federico-germinario/Pleasent_Ride/README.md

# Pleasent Ride

# Descrizione del progetto

L’obiettivo che ci siamo posti per questo progetto è stato quello di creare un dispositivo che raccolga dei dati riguardanti la qualità dell’aria e del manto stradale in alcuni tratti di strada di una città e che invii questi dati ad un cloud, che mostra in ogni momento il loro andamento.
L’idea è quindi quella di creare un sistema che, raccogliendo le informazioni sopracitate in tempo reale, possa fornire agli utenti la possibilità di scegliere il tragitto più piacevole possibile per spostarsi fra le strade di una città.   
Il dispositivo è pensato principalmente per le biciclette ma può essere adattato a qualsiasi mezzo che possa risentire di inquinamento e strade imperfette.
