federico-germinario/Pleasent_Ride/Slide.pdf

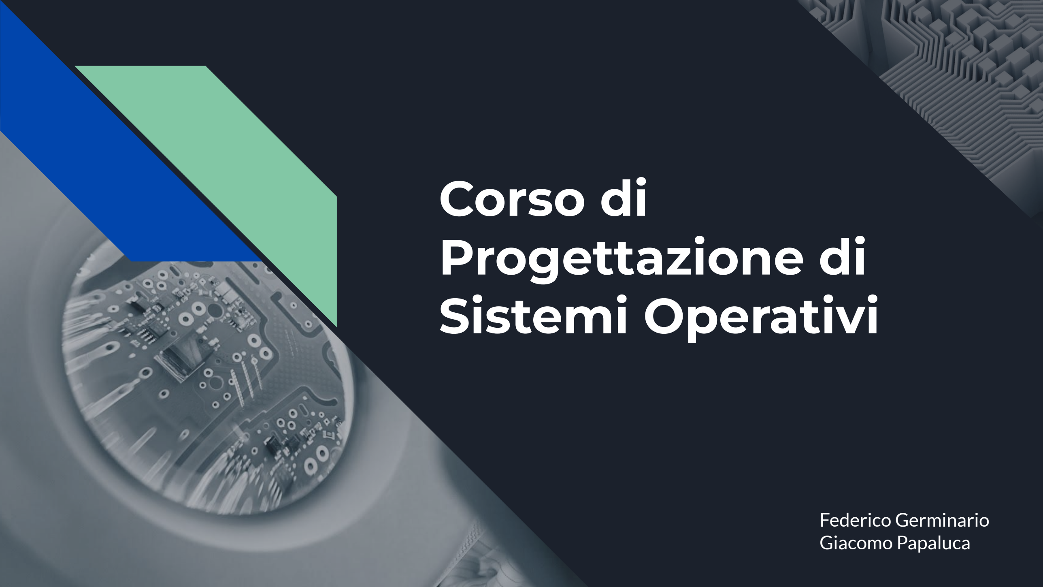
[picture p5: page 1]

# Corso di Progettazione di Sistemi Operativi

Federico Germinario
Giacomo Papaluca

# Introduzione

- Gran parte dei sistemi IoT al giorno d’oggi mira a garantire alle persone uno stile di vita più agiato e più salutare.
- L’obiettivo che ci siamo posti per questo progetto è stato quello di creare un dispositivo che raccolga dei dati riguardanti la qualità dell’aria e del manto stradale ed invii questi dati ad un cloud, che mostra in ogni momento il loro andamento.
- L’idea è quindi quella di creare un sistema che, raccogliendo le informazioni sopracitate in tempo reale, possa fornire agli utenti la possibilità di scegliere il tragitto più piacevole possibile per spostarsi fra le strade di una città.

# Cloud (ThingSpeak)

- ThingSpeak è una piattaforma open source che consente di aggregare, visualizzare e analizzare flussi di dati nel cloud provenienti da dispositivi IoT.
- I dati vengono archiviati in canali che possono essere pubblici o privati
- Ogni canale può contenere al massimo 8 serie di dati
- | GET | https://api.thingspeak.com/update?api_key=MK77FV2ZF1VMIUYQ&field1=0

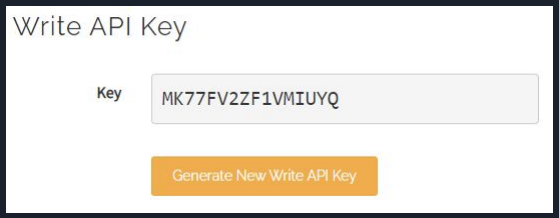
[picture p6: figure]

# ThingSpeak

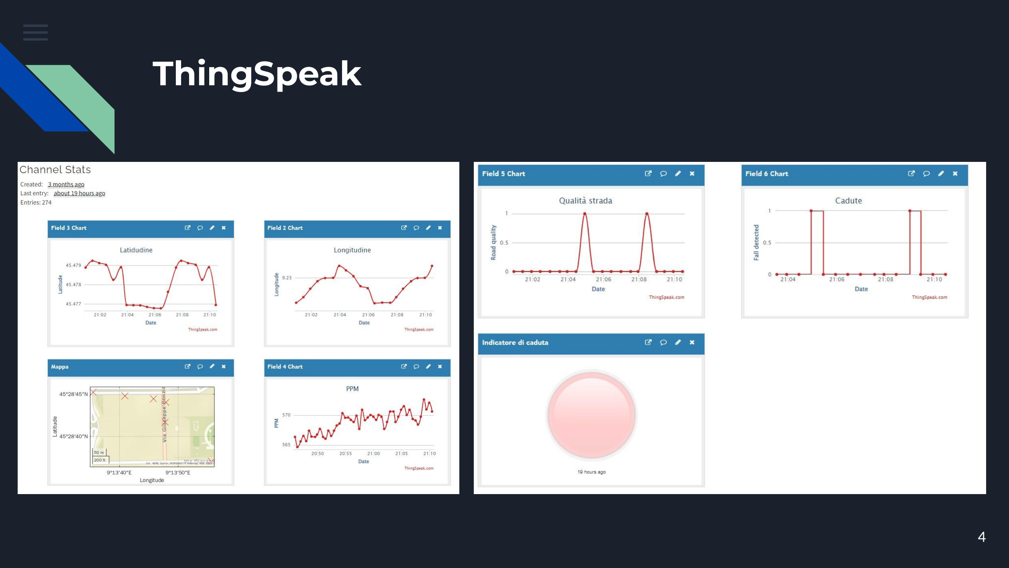
[picture p7: page 4]

# Architettura del sistema

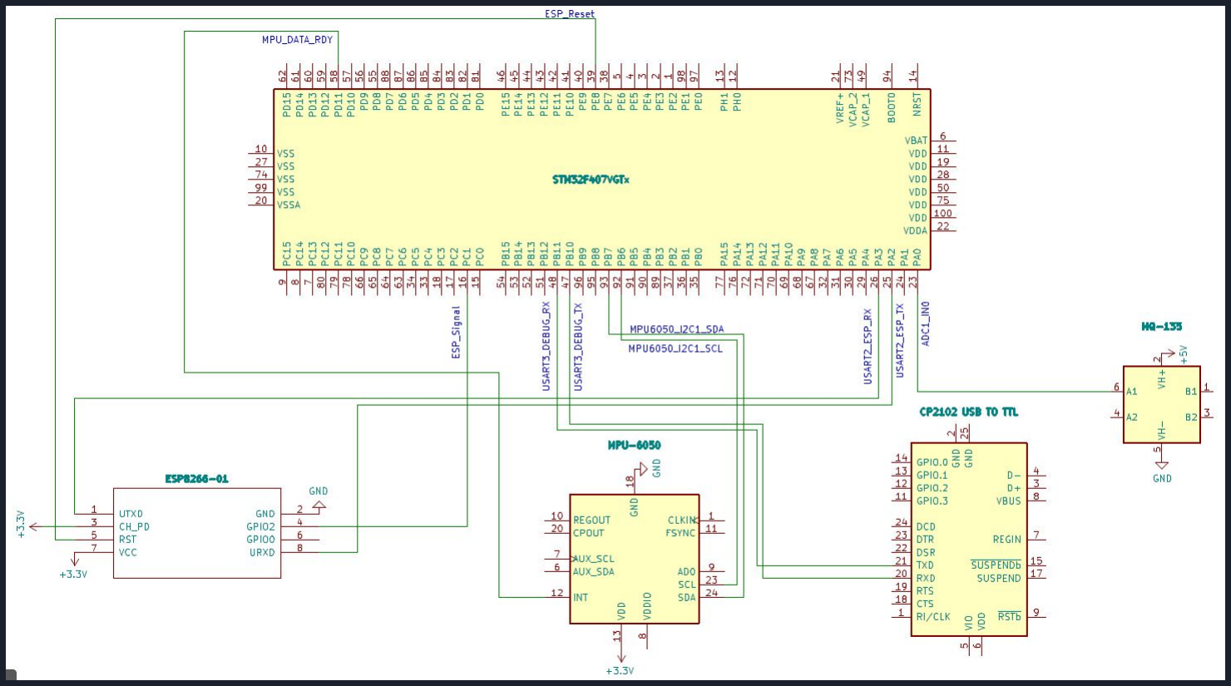
[picture p8: figure]

# ESP8266-01

- l’ESP8266 è un chip con WiFi integrato a basso costo
- Ha un supporto completo al protocollo TCP/IP

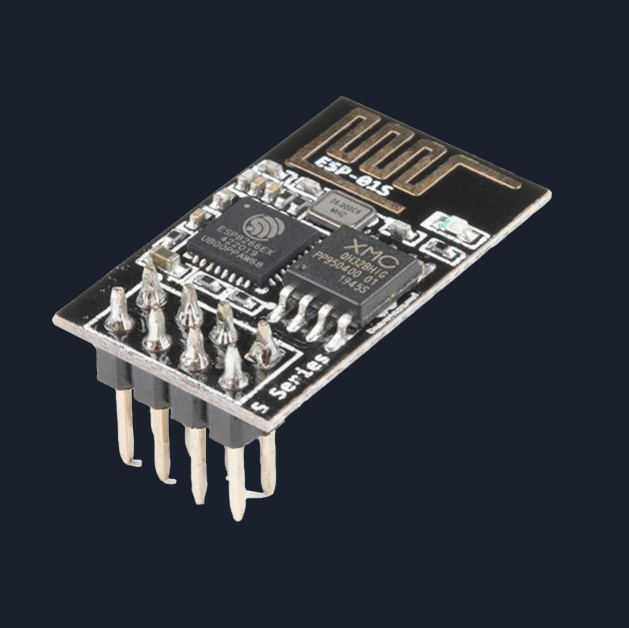
[picture p9: figure]

- Il modulo viene distribuito con un firmware ufficiale che permette di pilotarlo e gestirlo attraverso dei comandi AT
- Abbiamo scelto di riprogrammare il dispositivo in modo da adattarlo ai nostri bisogni

Caratteristiche tecniche:
- Processore: RISC a 32 bit (80/160 Mhz)
- 64 KByte di RAM per le istruzioni
- 96 KByte di RAM dati
- UART su pin dedicati
- 2 PIN GPIO

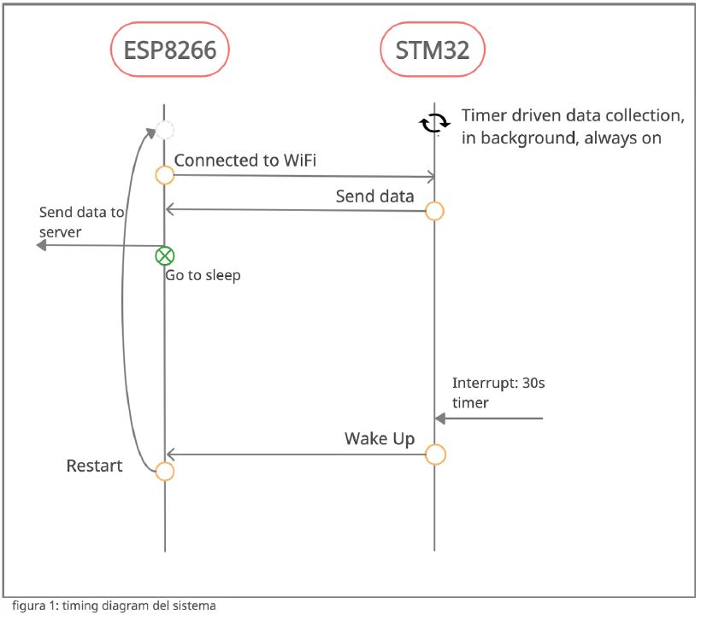
[picture p10: figure]

1. L’STM32 raccoglie i dati di interesse
1.1. nel frattempo la scheda di rete cerca di connettersi ad un hotspot e una volta connetto invia un segnale all’STM32
2. Il segnale giunge all’STM32 e invia tutti i dati all’ESP
3. L’ESP invia i dati a ThingSpeak e va in deep sleep
4. Alla scadenza di un timer da 30 secondi l’STM32 invia un segnale di Wake Up alla scheda di rete e il ciclo viene ripetuto

# Ciclo di vita dell’ESP8266

# Codice ESP8266

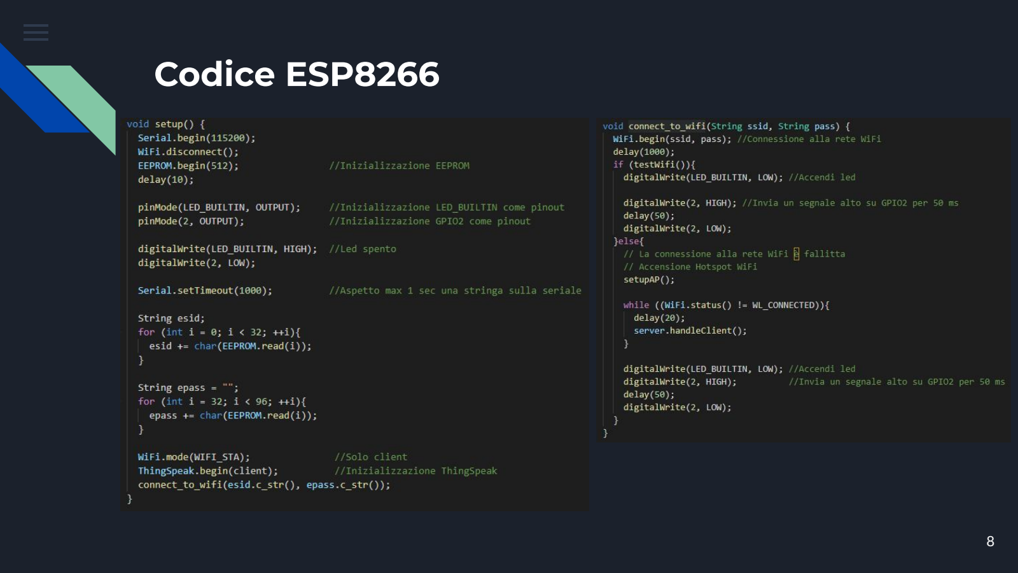
[picture p11: page 8]

# Codice ESP8266

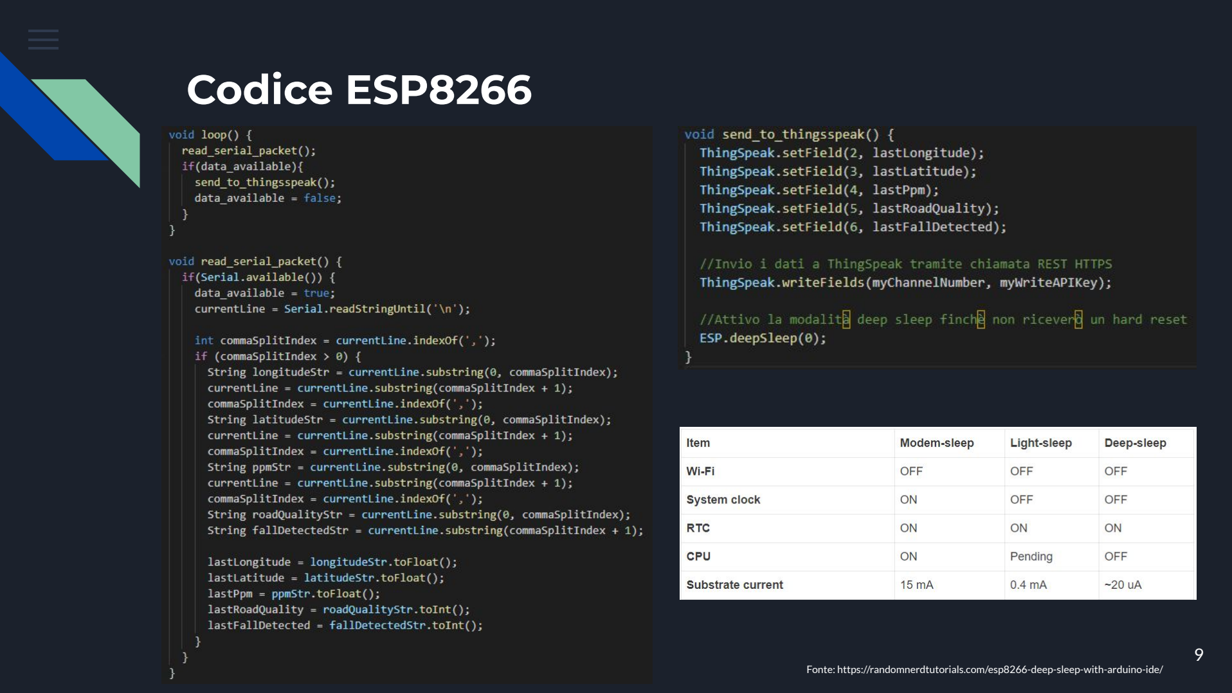
[picture p12: page 9]

Fonte: https://randomnerdtutorials.com/esp8266-deep-sleep-with-arduino-ide/

# STM32F407VGT6-DISC1

Centro nevralgico del sistema:
- Inizializza tutti i componenti periferici e li controlla con un paradigma timer driven:
- gestione ciclo di vita ESP-01 con reset ogni 30s ed ESP Signal
- trasferimenti in RAM da MPU6050 con I2C DMA ogni 8s (road quality)
- ADC1 ch0 su TRGO di TIM3 per leggere dati ogni 5s da MQ135 (air quality)
- Colleziona, elabora ed infine invia al cloud i dati rilevati
- Utilizza SleepOnExit per risparmio energetico

Caratteristiche tecniche:
- Processore: 32-bit Arm® Cortex®-M4 with FPU core (168 MHz max, usato a 50 MHz)
- 192 KByte di RAM
- 1 Mbyte Flash memory

# STM32F407 (Main)

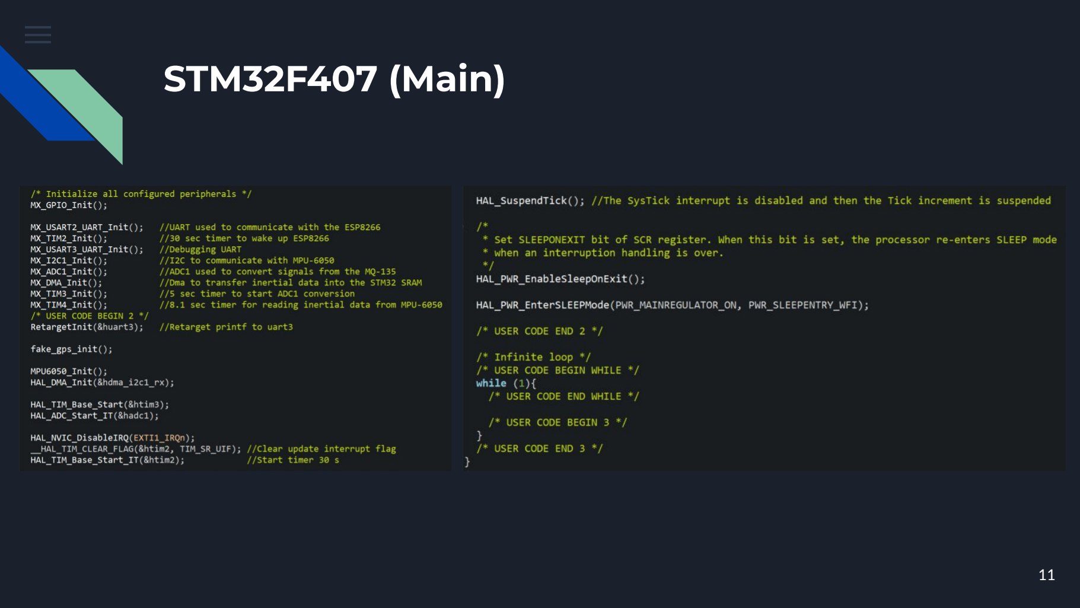
[picture p13: page 11]

# TIM 2

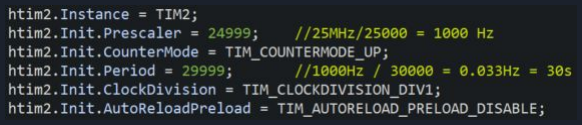
[picture p14: figure]

UpdateEvent = Timer_clock /( (Prescaler + 1) * (Period + 1) ) = 25 MHz / ( (24999 + 1) * (29999 + 1)) = 25 MHz / 750 M
= 0,033 Hz = 1/0,033 s ⩬ 30 s

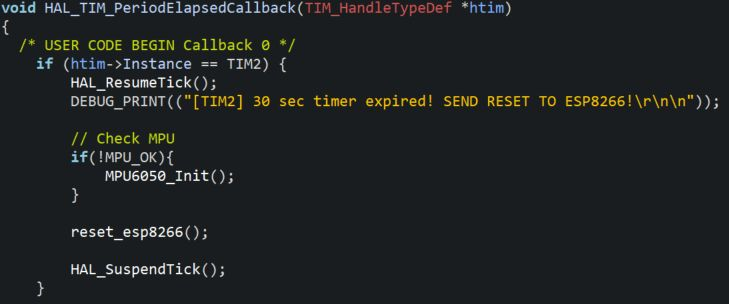
[picture p15: figure]

# Problema rimbalzi ESP8266

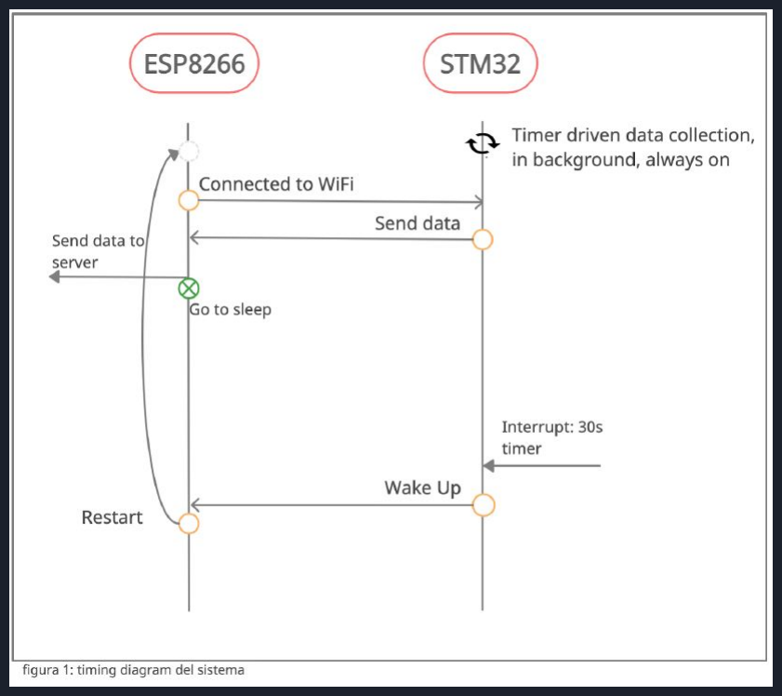
[picture p16: figure]

- Dopo l’hard reset il dispositivo invia dei segnali spuri all’STM32
- Questo causava l’attivazione di molte callback lato STM32
- Circuito anti-rimbalzo (filtro passa basso di tipo R-C)
- Problema risolto via software

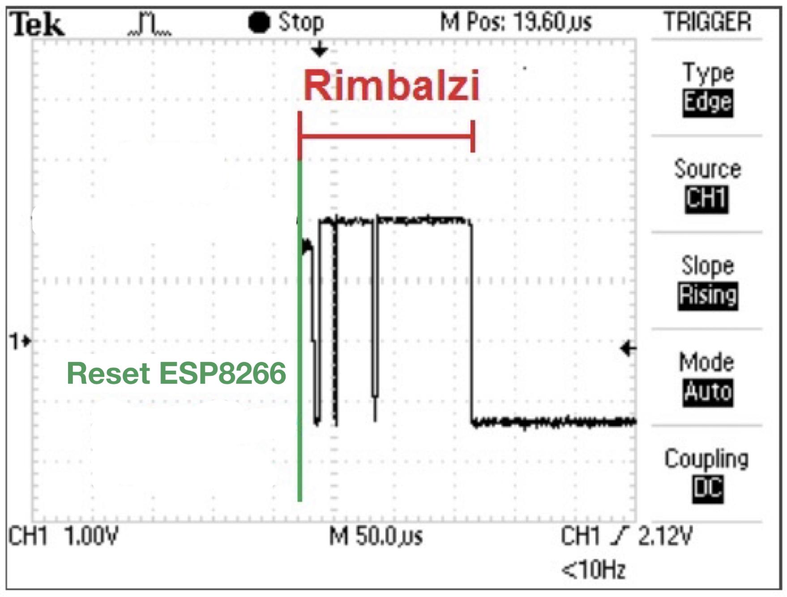
[picture p17: figure]

# Risoluzione problema rimbalzi ESP8266

- Nel main disattivo le callback dell’EXTI1
- Quando TIM 2 scade viene chiamata la funzione reset_esp8266()
- Quando ricevo il segnale da parte dell’ESP che è riuscito a connettersi ad una rete WiFi (ESP_Signal), aggrego i dati, li invio alla scheda di rete e disattivo le callback dell’EXTI1

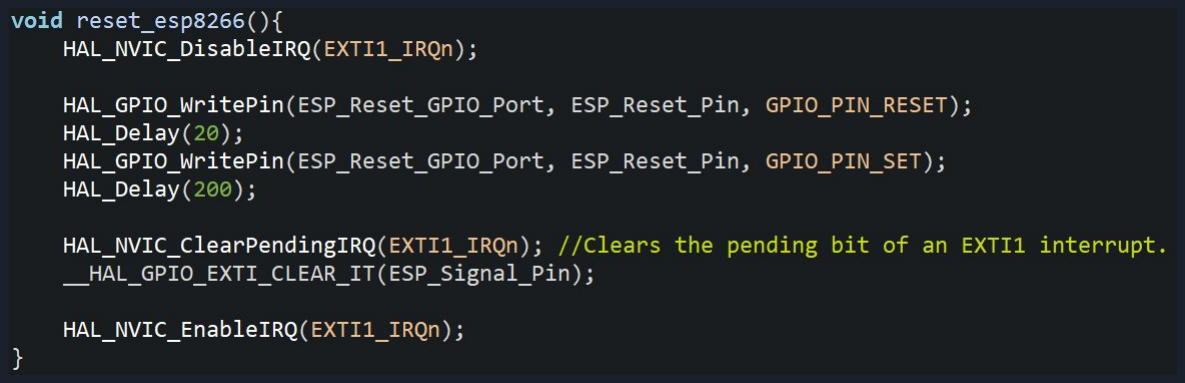
[picture p18: figure]
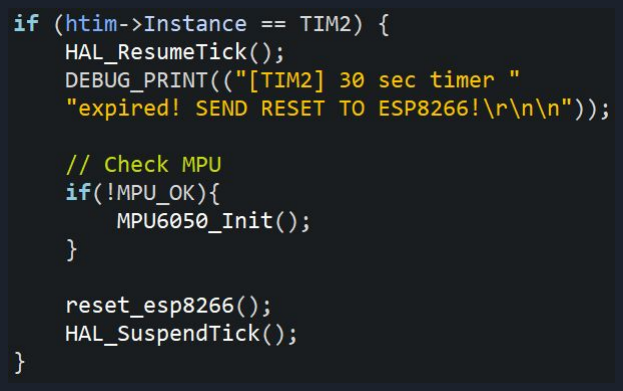
[picture p19: figure]

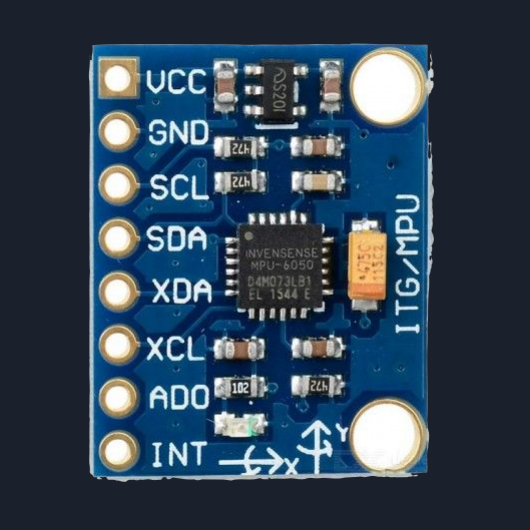
[picture p20: figure]

# MPU-6050

- Microprocessore dotato di vari MEMS e ADC
- Usato per raccogliere dati sulla qualità del manto stradale
- 3-axis accelerometer e 3-axis gyroscope (fs: 1 KHz)
- Interrupt pin per comunicare l’avvio delle misurazioni
- Buffer fifo da 1024 byte per accumulare misurazioni (12 byte per ogni misurazione accel+gyro)
- Prescaler di /100 per ridurre il data rate a 10Hz e ridurre quindi i consumi
- Parametri settati attraverso scrittura dei registri: HAL_I2C_Mem_Write() da STM32

# Inizializzazione MPU-6050

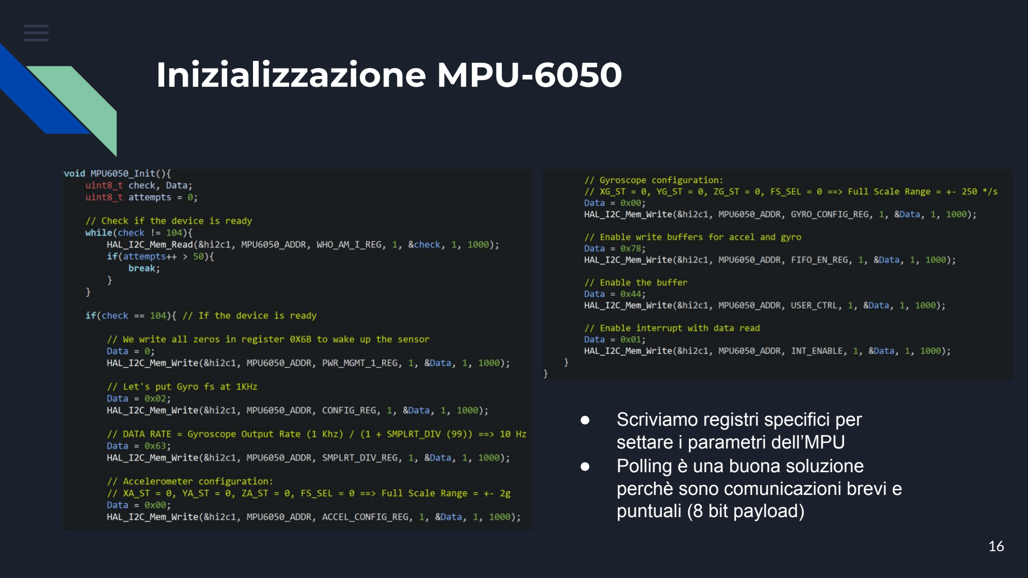
[picture p21: page 16]

- Scriviamo registri specifici per settare i parametri dell’MPU
- Polling è una buona soluzione perchè sono comunicazioni brevi e puntuali (8 bit payload)

# Calibrazione MPU-6050

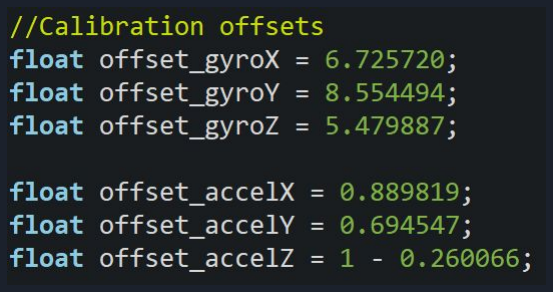
[picture p22: figure]

- Dobbiamo assicurarci che i dati del sensore siano corretti

Calibrazione:

- Teniamo fermo l’MPU, appoggiato su una superficie piana
- Leggiamo una serie di valori misurati (qualche centinaia di misurazioni)
- Facciamo una media di quelle misurazioni e salviamo le medie per ogni asse nelle variabili offset_*
- Ad ogni misurazione effettuata dal microprocessore aggiungiamo l’offset in modo che a sensori fermi le misurazioni sugli assi siano il più vicino possibile a 0

# I2C Protocol

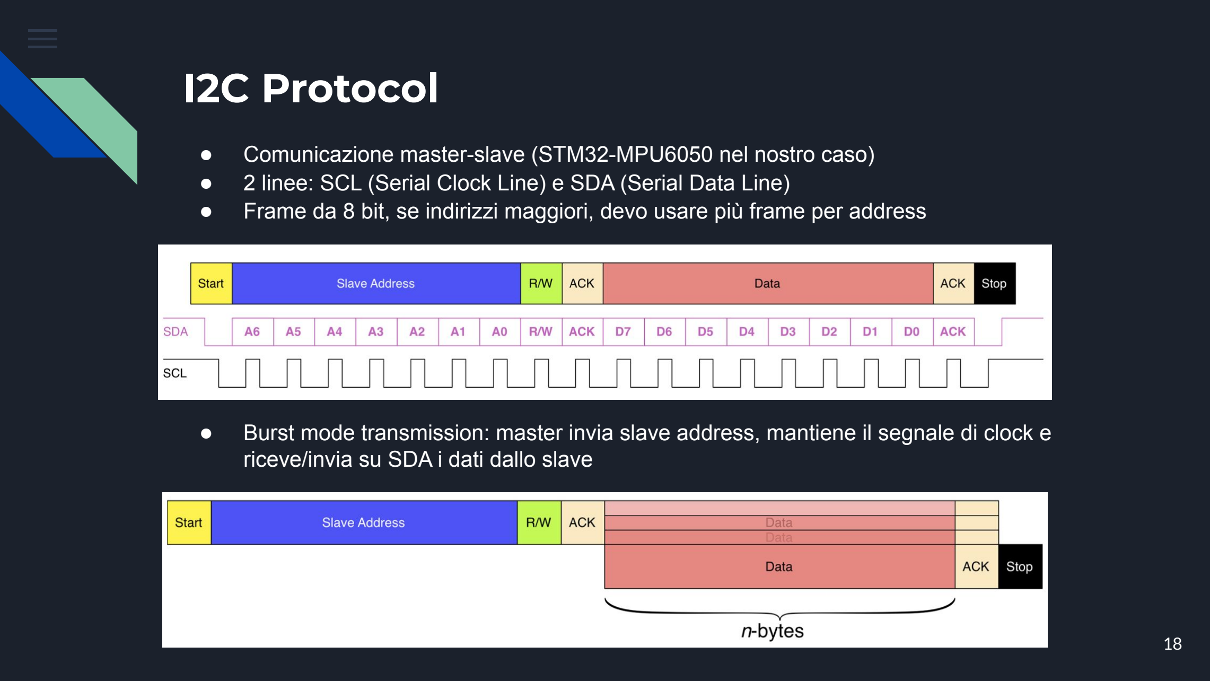
[picture p23: page 18]

- Comunicazione master-slave (STM32-MPU6050 nel nostro caso)
- 2 linee: SCL (Serial Clock Line) e SDA (Serial Data Line)
- Frame da 8 bit, se indirizzi maggiori, devo usare più frame per address
- Burst mode transmission: master invia slave address, mantiene il segnale di clock e riceve/invia su SDA i dati dallo slave

# MPU-6050 DATA RETRIEVING

- MPU FIFO buffer (1024 bytes) abilitato per salvare dati inerziali
- Al termine della prima misurazione manda interrupt a STM32 che fa partire TIM4 (8s)
- TIM4 period elapsed: sospendo momentaneamente la scrittura del buffer per poterlo leggere e avvio la richiesta di trasmissione master-slave I2C
- invio registro FIFO_RW allo slave per dire che voglio leggere il fifo
- leggo in burst mode tutti i byte del fifo
- Trasmissione effettuata da DMA da peripheral a memory => grossa mole di dati, risparmiamo CPU time

# MPU-6050 DATA PROCESSING

- Metodo sliding windows per assicurarsi di non perdere informazioni
- Misurazioni suddivise in finestre di 20 misurazioni, 50% overlap
- Tipicamente 960 byte, 80 misurazioni per accel e 80 per gyro ==> 7 finestre per ogni burst di dati
- Overlap ci permette di evitare che un evento che accade tra 2 finestre non venga saltato

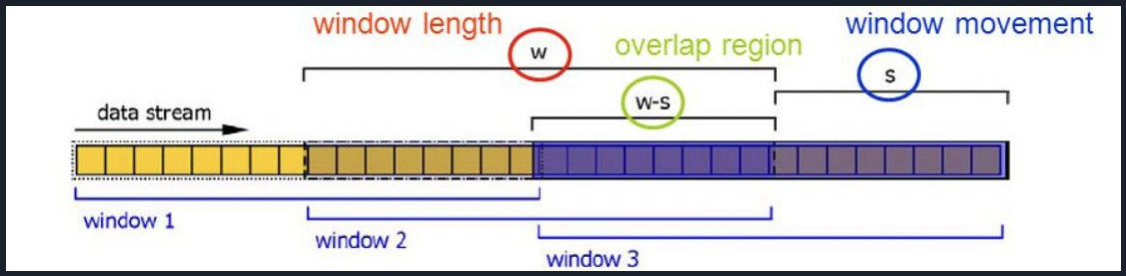
[picture p24: figure]

# MPU-6050 DATA PROCESSING (2)

- Per ogni finestra di misurazioni:
- calcoliamo vettore risultante di componenti x,y e z di accelerometro e giroscopio
- salviamo i vettori in array ausiliari e calcoliamo le medie delle intensità delle accelerazioni lineari
- Algoritmo per qualità della strada:
- una soglia è calcolata come inversamente proporzionale all’intensità dell’accelerazione angolare
- conto quante volte in ogni finestra un vettore di accelerazione lineare supera in intensità la media della finestra di un valore pari o maggiore alla soglia
- un manto stradale pessimo produrrà molte vibrazioni => verranno contate molte misurazioni
- un manto stradale in buone condizioni produce poche vibrazioni => il conteggio sarà prossimo allo 0
- Rilevazione cadute:
- riconosco una serie di misurazioni ad alta intensità di vibrazione
- attendo un periodo di tempo (60 misurazioni, da testare in un contesto vero)
- se rilevo stabilità nel device (utente fermo) suppongo sia caduto

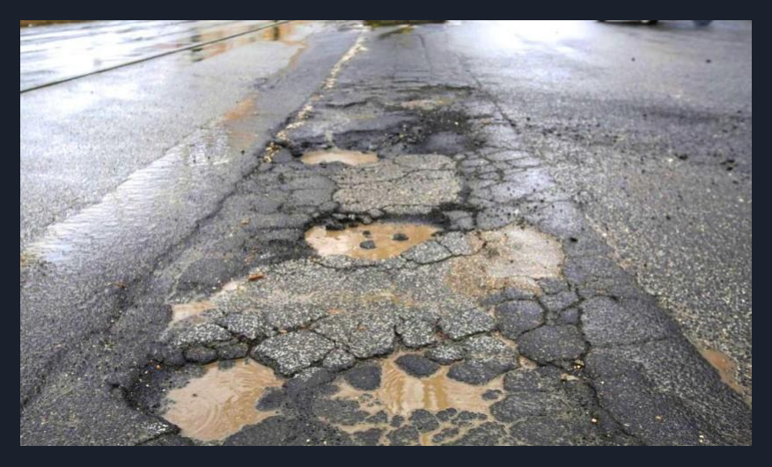
[picture p25: figure]
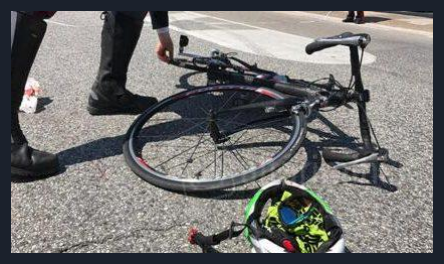
[picture p26: figure]

MQ-135

- Semplice componente passivo dotato di una resistenza variabile

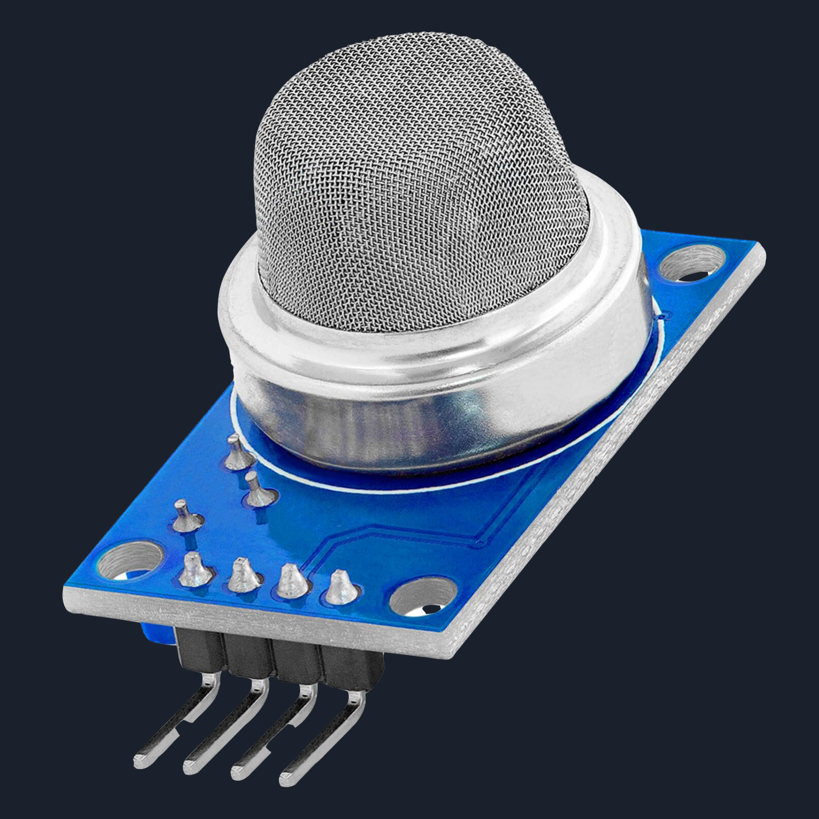
[picture p27: figure]

- La resistenza varia a seconda della concentrazione di molecole di sostanze nell’aria
- La tensione in uscita cresce al crescere di questa concentrazione (aria meno pura)
- Calibrato per la Co2:
- posizionato in un ambiente con ppm di Co2 noto (fonte)
- misurata tensione in uscita con voltmetro

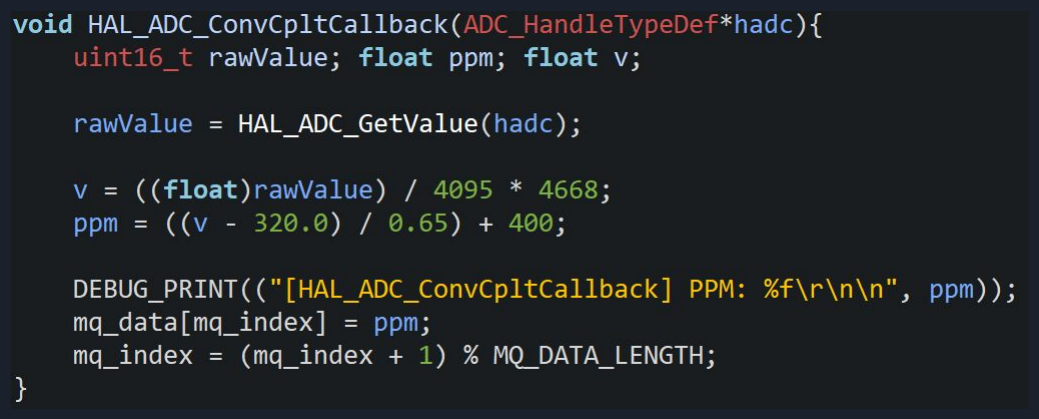
[picture p28: figure]

- Sapendo che a 400 ppm l’output
è di 320 mV
- Misurando la vcc come 4.668 V (non esattamente 5V)
- Usando un ADC con risoluzione 12 bit
- La formula a fianco calcola la traduzione da tensione a ppm

# MQ-135 DATA GATHERING AND PROCESSING

- La lettura del sensore viene effettuata ad ogni overflow del timer TIM3 (5s)
- Per evitare interrupt inutili:
- l’interrupt di TIM3 è disattivato nell’NVIC
- l’ADC è settato in modalità timer driven attraverso la TRGO line di TIM3
- conversione effettuata in automatico ad ogni overflow
- a conversione terminata conv completed callback calcola il valore di inquinamento
- Le letture vengono salvate in un array
- Quando i dati vengono inviati al cloud invio una media delle letture nell’array

# Simulatore GPS

- Tutte le misurazioni effettuate devono avvalersi di una posizione GPS così da far corrispondere i valori acquisiti a un determinato punto sulla mappa.
- Abbiamo raccolto un insieme di coordinate GPS simulando un percorso
- Coordinate scaricate tramite Google Earth
- Tutte le coordinate (latitudine e longitudine) sono state memorizzate in un array circolare
- Ogni qual volta la scheda ESP8266 è pronta ad inviare i dati al server, viene selezionata una coordinata dell'array e viene inviata ad essa insieme a tutti gli altri dati calcolati.

# Analisi dei tempi di esecuzione

- Applicazione ciclica, timer driven
- Non sarebbe rilevante calcolare un unico tempo di esecuzione
- Abbiamo calcolato i tempi di esecuzione delle callback
- Il collo di bottiglia è la callback HAL_I2C_MasterRxCpltCallback
- Registro CYCCNT dell’unità DWT

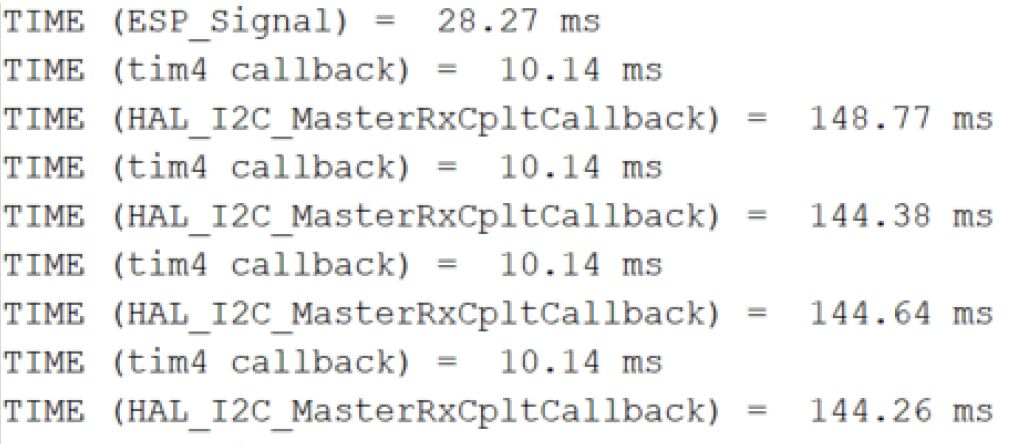
[picture p29: figure]

# Analisi del consumo

- Punto focale del nostro progetto
- Abbiamo evitato l’utilizzo di un real time OS
- Utilizzo solo di APIs HAL
- Deep Sleep ESP8266 (20 uA vs 50 mA in running mode)
- STM32: HAL_PWR_EnableSleepOnExit()
- Utilizzando la SleepOnExit abbiamo dimezzato il consumo medio della scheda
- Siamo passati da circa 20 mA a 10 mA di corrente dissipata

# Analisi del consumo

- ESP8266 lavora in run mode (50 mA) per circa 2 secondi e in Deep Sleep (0.02 mA) per circa 28 secondi
- Il consumo medio del dispositivo è di 3.3 mA
- MPU-6050 ha un consumo massimo di 3.9 mA
- Il consumo medio del sistema è circa 17.2 mA (10 mA + 3.9 mA + 3.3 mA)
- Con un power bank da 10000 mAh il sistema può essere alimentato per circa 580 ore
- Il collo di bottiglia è sicuramente l’MQ-135 che consuma in media 150 mA
- In commercio sono presenti sensori più costosi che assorbono molto meno

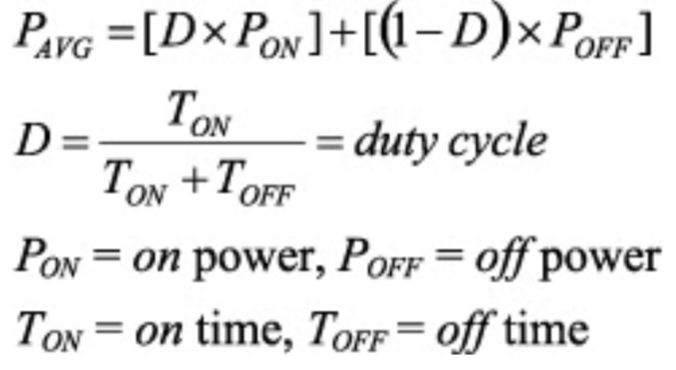
[picture p30: figure]

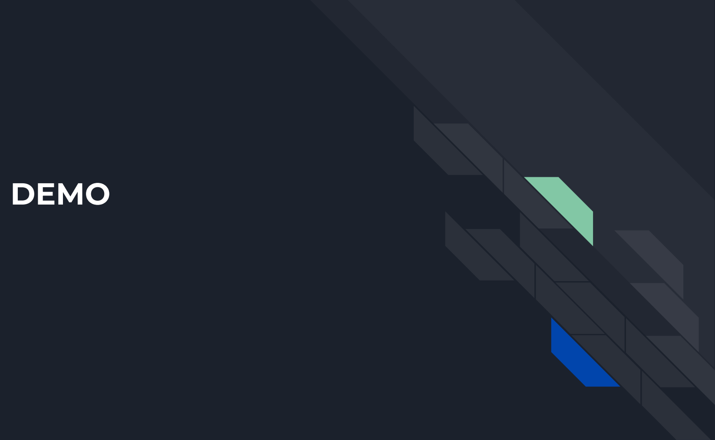
[picture p31: figure]
DEMO
