federico-germinario/Pleasent_Ride/Core/Inc/main.h

#define ESP_Signal_Pin GPIO_PIN_1
#define ESP_Signal_GPIO_Port GPIOC
#define ESP_Signal_EXTI_IRQn EXTI1_IRQn
#define USART2_ESP_TX_Pin GPIO_PIN_2
#define USART2_ESP_TX_GPIO_Port GPIOA
#define USART2_ESP_RX_Pin GPIO_PIN_3
#define USART2_ESP_RX_GPIO_Port GPIOA
#define ESP_Reset_Pin GPIO_PIN_8
#define ESP_Reset_GPIO_Port GPIOE
#define USART3_DEBUG_TX_Pin GPIO_PIN_10
#define USART3_DEBUG_TX_GPIO_Port GPIOB
#define USART3_DEBUG_RX_Pin GPIO_PIN_11
#define USART3_DEBUG_RX_GPIO_Port GPIOB
#define MPU_DATA_RDY_Pin GPIO_PIN_11
#define MPU_DATA_RDY_GPIO_Port GPIOD
#define MPU_DATA_RDY_EXTI_IRQn EXTI15_10_IRQn
#define MPU6050_I2C1_SCL_Pin GPIO_PIN_6
#define MPU6050_I2C1_SCL_GPIO_Port GPIOB
#define MPU6050_I2C1_SDA_Pin GPIO_PIN_7
#define MPU6050_I2C1_SDA_GPIO_Port GPIOB
