federico-germinario/Pleasent_Ride/ESP8266/settings.h

#ifndef SRC_SETTINGS_H_
#define SRC_SETTINGS_H_

#define CH_ID 1			            //ThingSpeak channel number 
#define APIKEY "MK77FV2ZF1VMIUYQ"   //ThingSpeak write API Key: key to write data to a channel

#endif
