federico-germinario/Pleasent_Ride/(commit log)

2021-10-30 uart esp8266
2021-12-05 added mq sensor timer driven ADC
2021-12-14 retarget uart
2021-12-28 MPU6050 IMU Integration
2022-01-18 add KiCad file
    [Architectural scheme.sch]
2022-02-04 Last commit
    [Architectural scheme.sch]
